thanhduy1806/EMBEDDED_LAB_TASK_1/BÀI_1/Project Outputs for BÀI_1/BOM.xlsx

Comment | Description | Designator | Footprint | LibRef | Quantity | Manufacturer | Manufacturer Part Number
4u7 |  | C200 | CAPC1005X55X30LL05T10 | CMP-0001-00074-2 | 1 | Kemet
100n |  | C201, C202, C203, C204, C205 | CAPC1005X55X30LL05T10 | CMP-0001-00074-2 | 5 | Kemet
1u |  | C206 | CAPC1005X70N | MAASL105CD7105MFCA01 | 1
100n | CAP CER 0.1UF 10V X5R 0402 | C207, C208, C209 | FP-C0402-BB-MFG | CMP-2008-02046-2 | 3 | Kemet | C0402C104K8PACTU
20pF | Dán | C210, C211 | tu 0805 | Tu 0805 20pF 50V 10% | 2
2u2 | Dán | C212, C213 | tu 0805 | Tu 0805 225 25V 10% | 2
100n | CAP CER 0.1UF 50V X7R 0402 | C300A, C300B | FP-0402B104K500CT-IPC_C | CMP-45632-000010-1 | 2
10u | Chip Multilayer Ceramic Capacitors for General Purpose, 1206, 10uF, X7R, 15%, 10%, 25V | C301A, C301B | FP-GRM31C-0_2-e0_3_0_8-MFG | CMP-06035-003589-1 | 2
1u | Chip Capacitor, 1 uF, +/- 10%, 50 V, -55 to 125 degC, 1206 (3216 Metric), RoHS, Tape and Reel | C302A, C320B | CAPC3216X110X50LL20T25 | CMP-2000-06011-1 | 2 | Kemet
10p |  | C303A, C303B | CAPC1608X90X35LL10T15 | CMP-2006-02592-1 | 2 | Murata
22u | Chip Multilayer Ceramic Capacitors for General Purpose, 0805, 22uF, X5R, 15%, 20%, 6.3V | C304A, C304B, C305A, C305B | FP-GRM21B-0_15-IPC_B | CMP-2007-03385-2 | 4
1u |  | C306A, C306B | CAPC2013X140X50NL20T25 | CMP-2007-03234-1 | 2 | Kemet
100n | Automotive Ceramic Capacitor, 0603, 100nF, 10%, X7R, 15%, 50V | C400A, C400B | FP-0603-L_1_6_0_15-W_0_81-IPC_A | CMP-2006-04386-2 | 2
22u | Tantalum Capacitor, 22 uF, +/- 10%, 10 V, -55 to 125 degC, 2-Pin SMD, RoHS, Tape and Reel | C401A, C401B | KEMT-T491-B_L | CMP-2000-07193-1 | 2 | Kemet
10u | Chip Capacitor, 10 uF, +/- 10%, 10 V, -55 to 125 degC, 1206 (3216 Metric), RoHS, Tape and Reel | C500A, C500B, C501A, C501B | CAPC3216X180X50LL20T25 | CMP-2000-06013-1 | 4 | Kemet
22u | CAP 22uF 6.3V ±20% 1206 (3216 Metric) Thickness 1.9mm SMD | C502A, C502B, C503A, C503B, C504A, C504B | CAPC1206(3216)190_L | CMP-1037-04986-1 | 6
100n | Cap Ceramic 100nF 50V X7R 10% Pad SMD 0603 +125°C Automotive T/R | C505A, C? | FP-CGA3E-0_3-0_1-IPC_A | CMP-2000-07546-2 | 2
LED | LED GREEN DIFFUSED 1206 SMD | D700, D701, D702 | FP-HSMG-C150-MFG | CMP-2000-05061-2 | 3 | Broadcom | HSMG-C150
XT30PW-M | Socket; DC supply; XT30; male; PIN: 2; on PCBs; THT; Colour: yellow | J300A, J300B, J301A, J301B | AMASS_XT30PW-M | XT30PW-M | 4
RPI GPIO Cconnector + 4 Cubesat pins |  | J600 |  | Connector GPIO | 1
S6B-XH-A (LF)(SN) | CONN HEADER R/A 6POS 2.5MM | J700 | FP-S6B-XH-A_LF_SN-MFG | CMP-17439-000165-2 | 1
4u7 | Surface Mount High Frequency Inductor, MLP Series, 4.7 H, 20%, 0805 [2012 Metric], 0.26 ohm | L200 | INDC2012X100N | MLP2012S4R7MT0S1 | 1
10u | 74477710, CUỘN CẢM LÕI FERALIT | L300A, L300B | WE-PD_7345 | CMP-0227-00113-2 | 2
1u5 | Shielded Wirewound Inductor 1.5uH 2500mA 0.072Ω 1008 (2520) | L500A, L500B | FP-DFE252010C-IPC_A | CMP-06042-006286-1 | 2
NT |  | N3A, NT1A, NT1B, NT2A, NT2B, NT3B | NET TIE | NET_TIRE | 6
61201021721 |  | P? | 61201021721 | CMP-1502-00021-2 | 1
TPCA8120 | MOSFET P-CH 20V 2A SSOT3 | Q400A, Q400B | FP-527AG-MFG | CMP-2100-03638-2 | 2
AO3400A | Trans MOSFET N-CH 30V 5.7A 3-Pin SOT-23 | Q700, Q701 | SOT95P280X125-3N | AO3400A | 2
10k | Chip Resistor, 10 KOhm, +/- 1%, 100 mW, -55 to 155 degC, 0603 (1608 Metric), RoHS, Tape and Reel | R200, R201, R204, R205, R206, R210, R301A, R301B, R302A, R302B, R304A, R304B | RESC1609X50X30NL8T20 | CMP-1666-00005-4 | 12 | Vishay Semiconductor
33k |  | R202, R203 | RESC1005X40X25ML05T10 | CMP-2002-07617-1 | 2 | Yageo / Phycomp
100R |  | R207, R208, R209, R700, R702 | RESC1005X40X25ML05T10 | CMP-2002-07344-1 | 5 | Yageo / Phycomp
0.025R | RES 0.025 OHM 1% 1W 2512 | R300A, R300B | FP-WSL2512-0_762-MFG | CMP-02407-013157-1 | 2
1M 1% |  | R303a, R303B | RESC1005X40X25NL05T10 | CMP-2002-07490-1 | 2 | Yageo / Phycomp
60k4 |  | R305A, R305B | RESC2013X50X30NL20T20 | CMP-2001-04043-1 | 2 | Vishay Dale
309k | ERJ-8ENF3093V | R306A, R306B | RESC3216X70X50LL05T20 | CMP-2003-00293-1 | 2 | Panasonic
10k | Chip Resistor, 10 KOhm, +/- 1%, 0.125 W, -55 to 155 degC, 0805 (2012 Metric), RoHS, Tape and Reel | R500A, R500B, R502A, R502B | RESC2013X60X35NL10T20 | CMP-1659-00013-4 | 4 | Yageo
1M 1% | Chip Resistor, 1 MOhm, +/- 1%, 100 mW, -55 to 155 degC, 0603 (1608 Metric), RoHS, Tape and Reel | R501A, R501B | RESC1608X55X25LL10T15 | CMP-1659-00056-1 | 2
180K | Chip Resistor, 180 KOhm, +/- 1%, 62.5 mW, -55 to 155 degC, 0402 (1005 Metric), RoHS, Tape and Reel | R503A, R503B | RESC1005X40X25NL05T10 | CMP-1011-00763-4 | 2 | Basic Passives
100R | Chip Resistor, 10 KOhm, +/- 1%, 100 mW, -55 to 155 degC, 0603 (1608 Metric), RoHS, Tape and Reel | R701, R703 | RESC1609X50X30NL8T20 | CMP-1666-00005-4 | 2 | Vishay Semiconductor
1k | Chip Resistor, 1 KOhm, +/- 1%, 0.125 W, -55 to 155 degC, 0805 (2012 Metric), RoHS, Tape and Reel | R704, R705 | RESC2013X70X40LL20T20 | CMP-2001-04375-5 | 2 | Panasonic
2k2 |  | R706 | RESC1609X50X30NL10T20 | CMP-2000-03167-1 | 1 | Vishay Dale
B3F-3152 | SWITCH TACTILE SPST-NO 0.05A 24V | SW200, SW201, SW202 | FP-B3F-3152-MFG | CMP-08834-000033-1 | 3
TestPoint |  | TP300A, TP300B, TP700, TP701 | PCBComponent_1 | TestPoint | 4
LT8611EUDD | IC REG BUCK ADJ 2.5A 24QFN | U300A, U300B | FP-UDD-24-05-08-1833-IPC_B | CMP-0491-02169-2 | 2
LTC4412ES6 | IC OR CTRLR SRC SELECT TSOT23-6 | U400A, U400B | FP-S6-6-05-08-1636-IPC_C | CMP-0479-00425-2 | 2
TPS63020DSJT | IC REG BCK BST ADJ 3.5A 14VSON | U500A, U500B | FP-DSJ0014A-MFG | CMP-2000-07282-2 | 2 | Texas Instruments | TPS63020DSJT
STM32F405RGT6 | ARM Cortex-M4 32-bit MCU+FPU, 210 DMIPS, 1024 kB Flash, 192 kB Internal RAM, 51 I/Os, 64-pin LQFP, -40 to 85 degC, Tray | U? | STM-LQFP64_N | CMP-0243-00019-3 | 2 | STMicroelectronics
8MHz | Low Profile Crystal, 8.0 MHz, +/- 30 ppm, -20 to 70 degC, 2-Pin SMD, RoHS, Tape and Reel | X? | ABRA-ABLS-14.7456MHZ-B2-T_V | CMP-2000-05726-1 | 1 | ABRACON
