thanhduy1806/EMBEDDED_LAB_TASK_1/ĐỀ/EPS_board.pdf

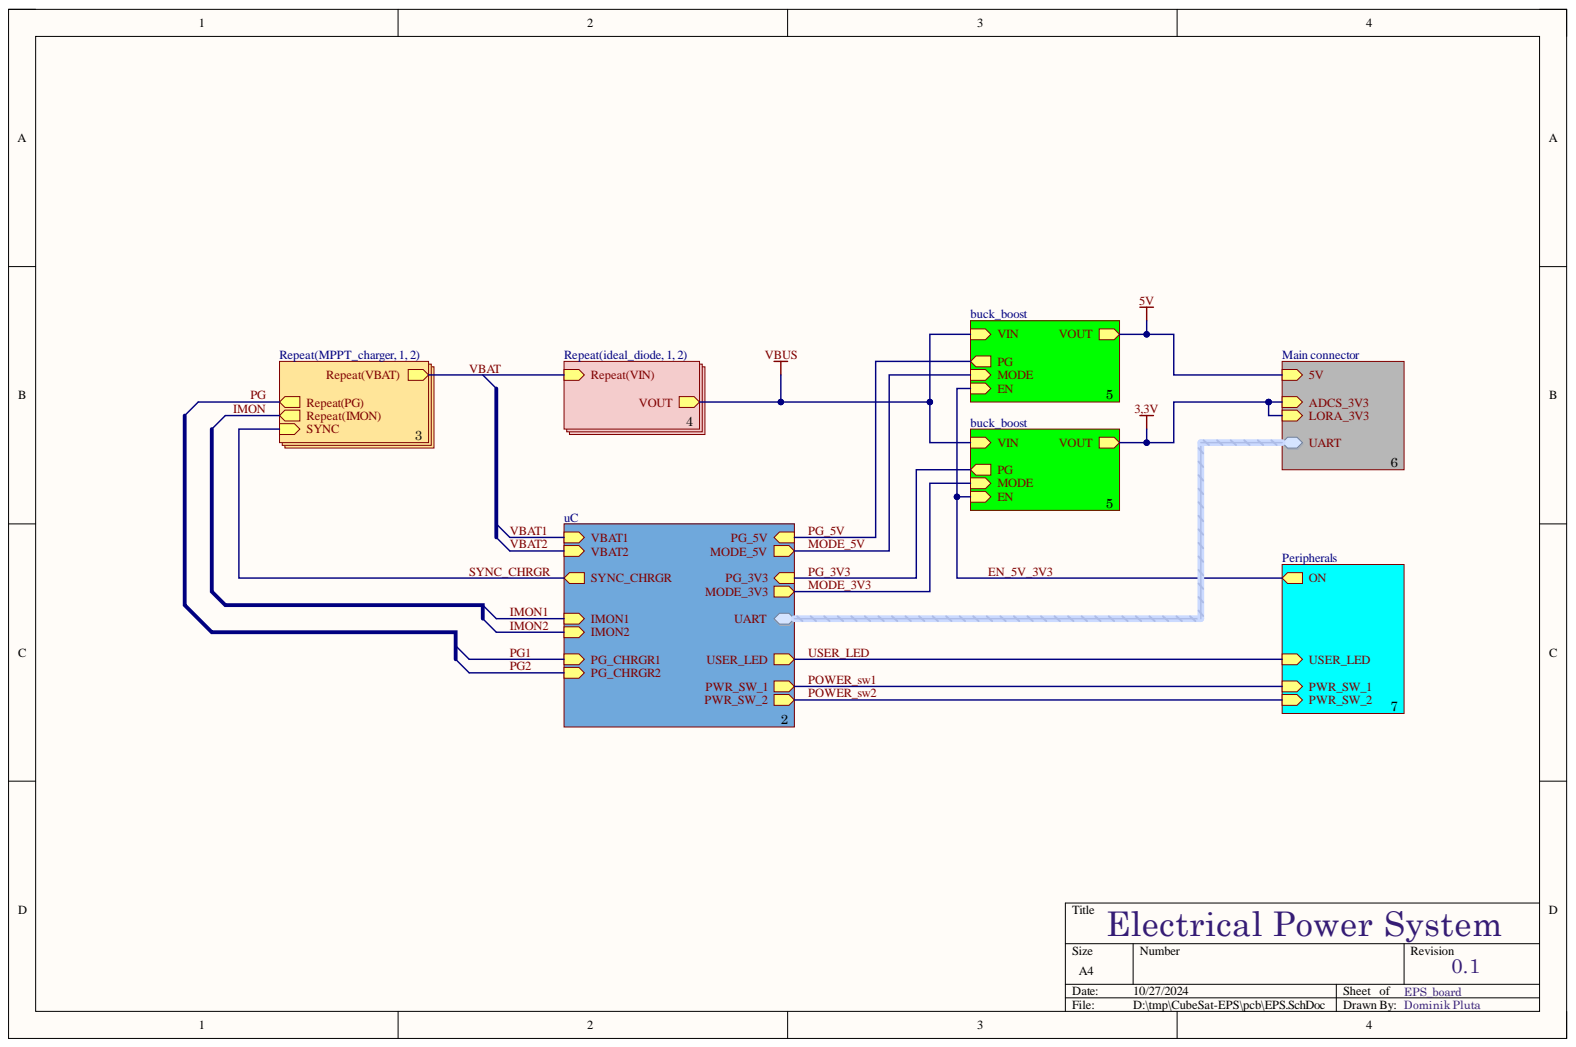
[picture p1: page 1]

PG_ 5 V
MODE _5 V

Siz e A4 | Numb e r | R evisio n 0 . 1

Da te : 10/27/20 24 | She et of EPS_boa r d
File : D:\tmp\Cube S at-EP S\pcb\EP S . S c hD o c | Dr awn B y : Dom i n ik Pl u t a

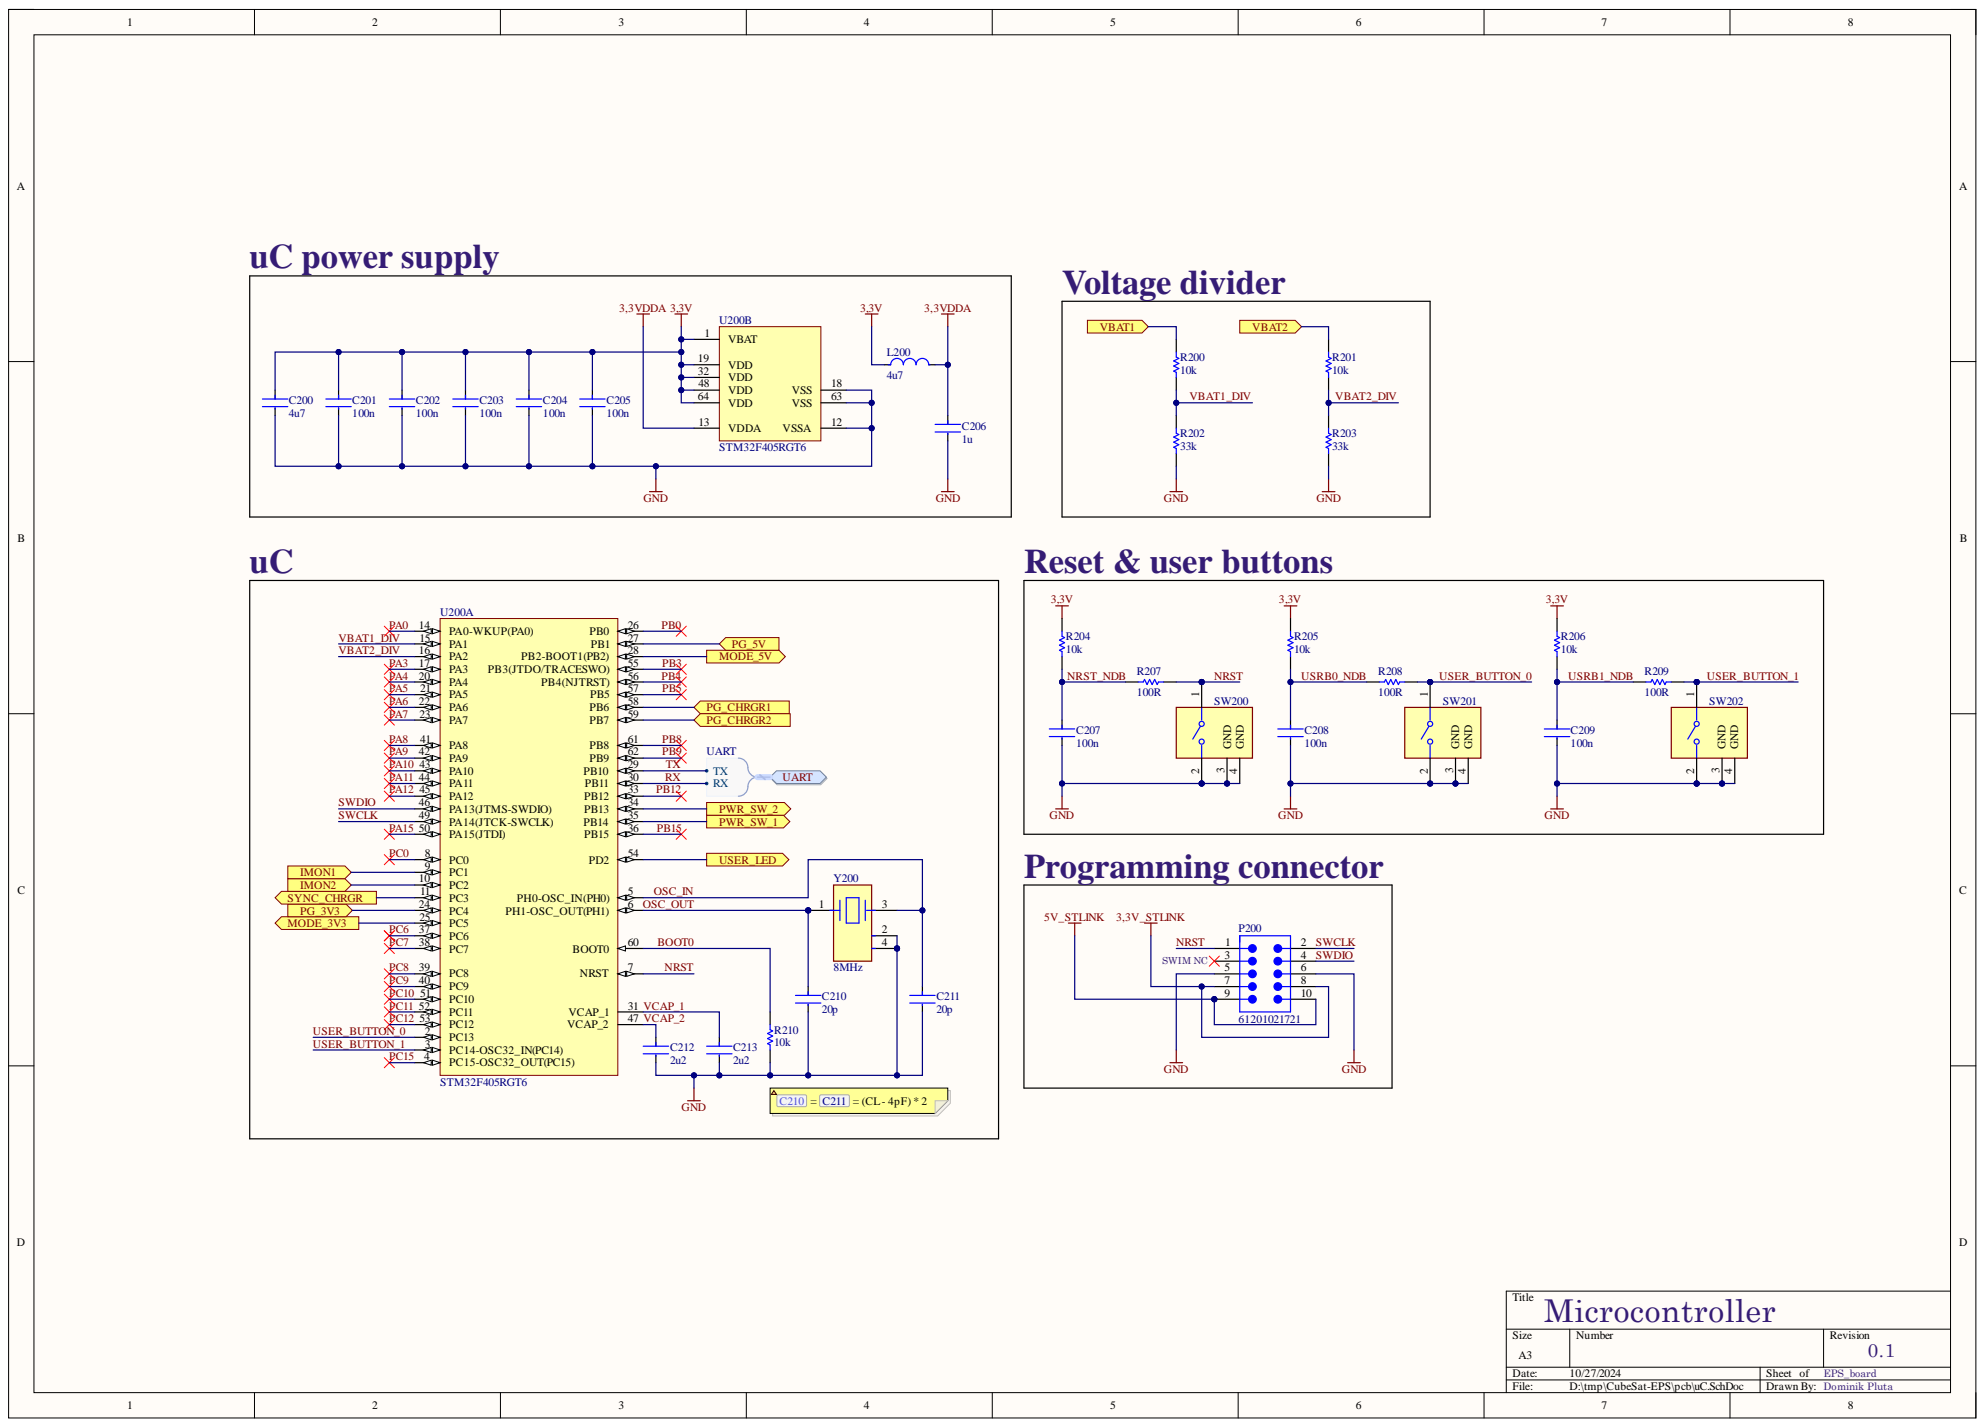
[picture p2: page 2]

VDD 19
VDD 32
VDD 48

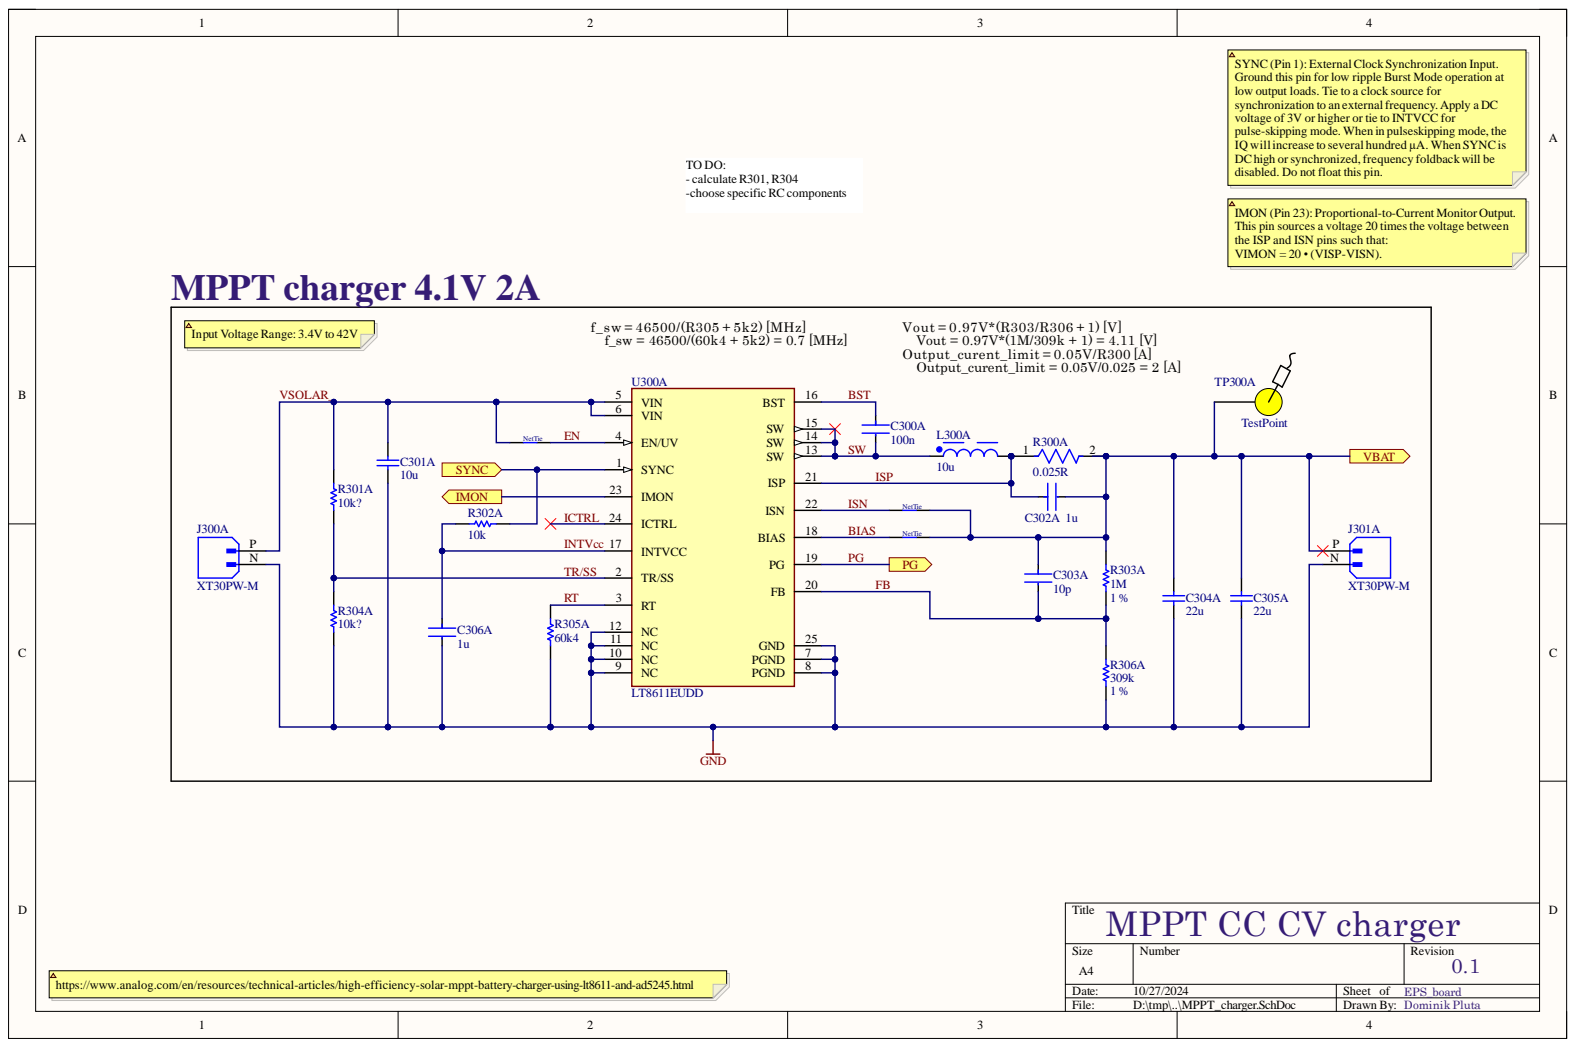
[picture p3: page 3]

SYNC(Pin 1): External Clock Synchronization Input.
Ground this pin for low ripple Burst Mode operation at
low output loads. Tie to a clock source for
synchronization to an external frequency. Apply a DC
voltage of 3V or higher or tie to INTVCC for
pulse-skipping mode. When in pulseskipping mode, the
IQ will increase to several hundred µA. When SYNCis
DChigh orsynchronized,frequency foldback will be
disabled. Do not float this pin.

IMON (Pin 23): Proportional-to-Current Monitor Output.
This pin sources a voltage 20 times the voltage between
the ISP and ISN pins such that:
VIMON = 20 • (VISP-VISN).

f_sw = 46500/(60k4 + 5k2) = 0.7 [MHz] Input VoltageRange: 3.4V to 42V

EN NetTie | VIN 6

SYNC 1

ICTRL | ICTRL 24 | ISN NetTie

BIAS NetTie

Title
MPPT CC CV charger

Size A4 | Number | Revision 0.1

https://www.analog.com/en/resources/technical-articles/high-efficiency-solar-mppt-battery-charger-using-lt8611-and-ad5245.html

Date: 10/27/2024 | Sheet of EPS_board
File: D:\tmp\..\MPPT_charger.SchDoc | Drawn By: Dominik Pluta

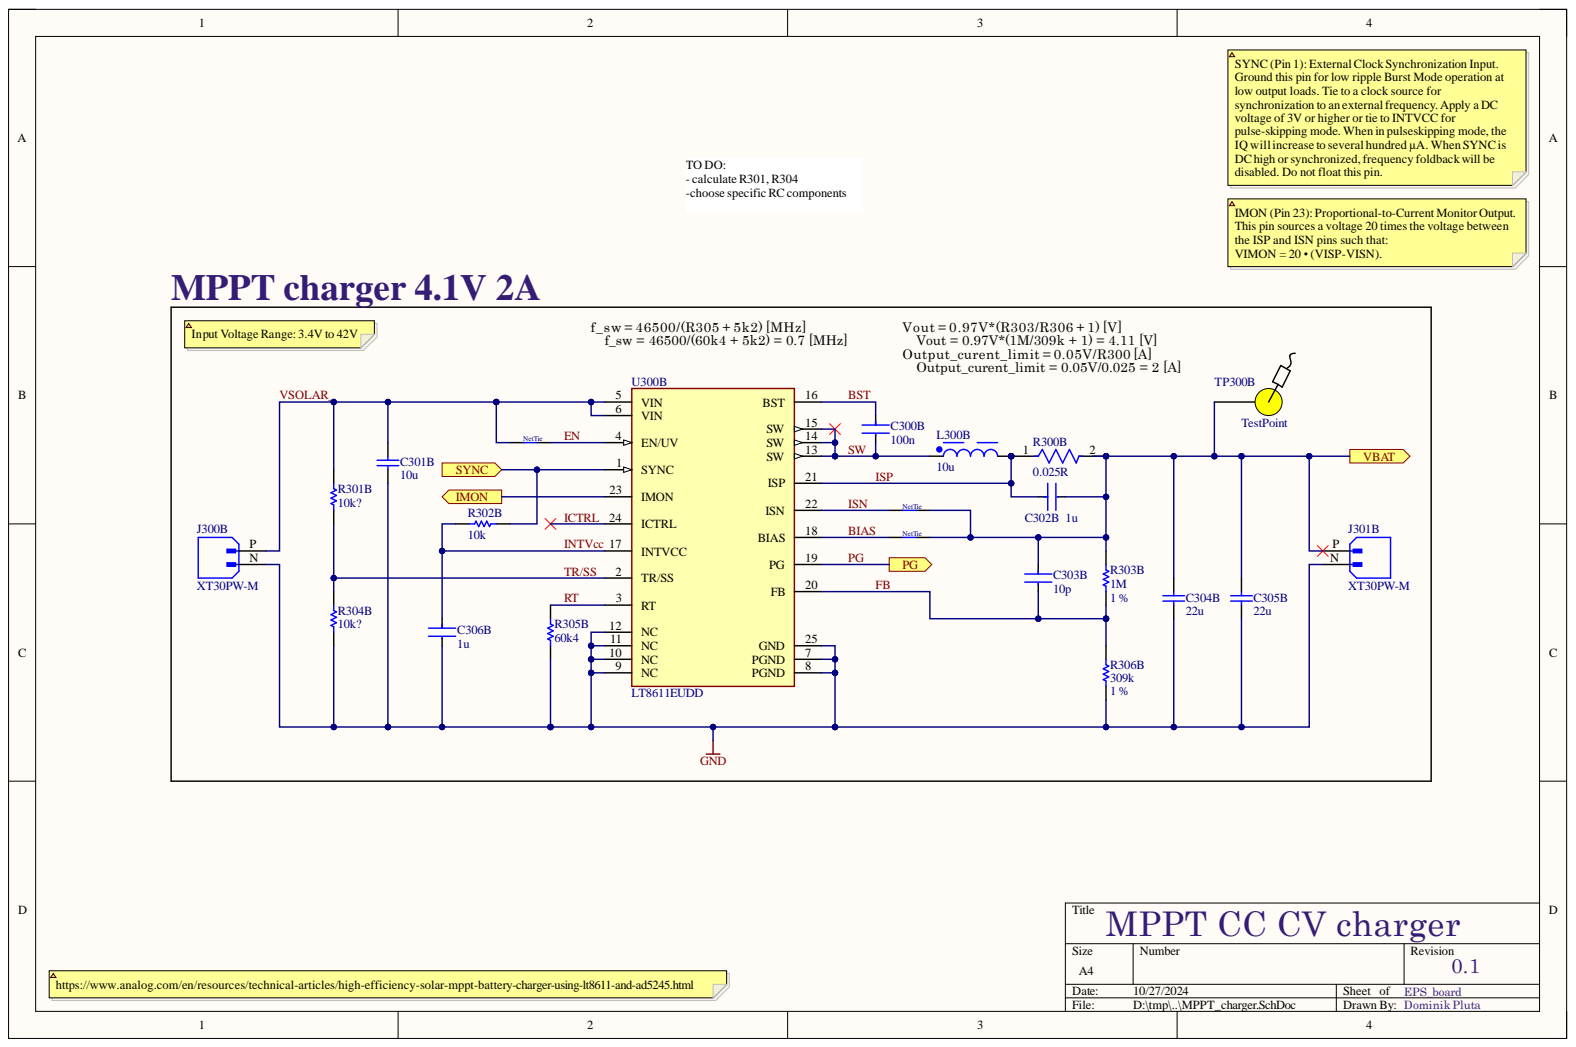
[picture p4: page 4]

SYNC
Ground this pin
low output loads.
synchroniz
voltage of 3V or highe
pulse
DChigh orsynchroniz

When in pulseskipping mode
al hundr

a voltage 20 times the voltage betwe
SN pins such that:

B IAS N e t Ti e

Siz e A4 | Numb e r | R evisio n . 1

Da te : 10/27/20 24 | She et of EPS_boa r d
File : D:\tmp\. .\MP PT_c h ar g e r . S c hD o c | Dr awn B y : Dom i n ik Pl u t a

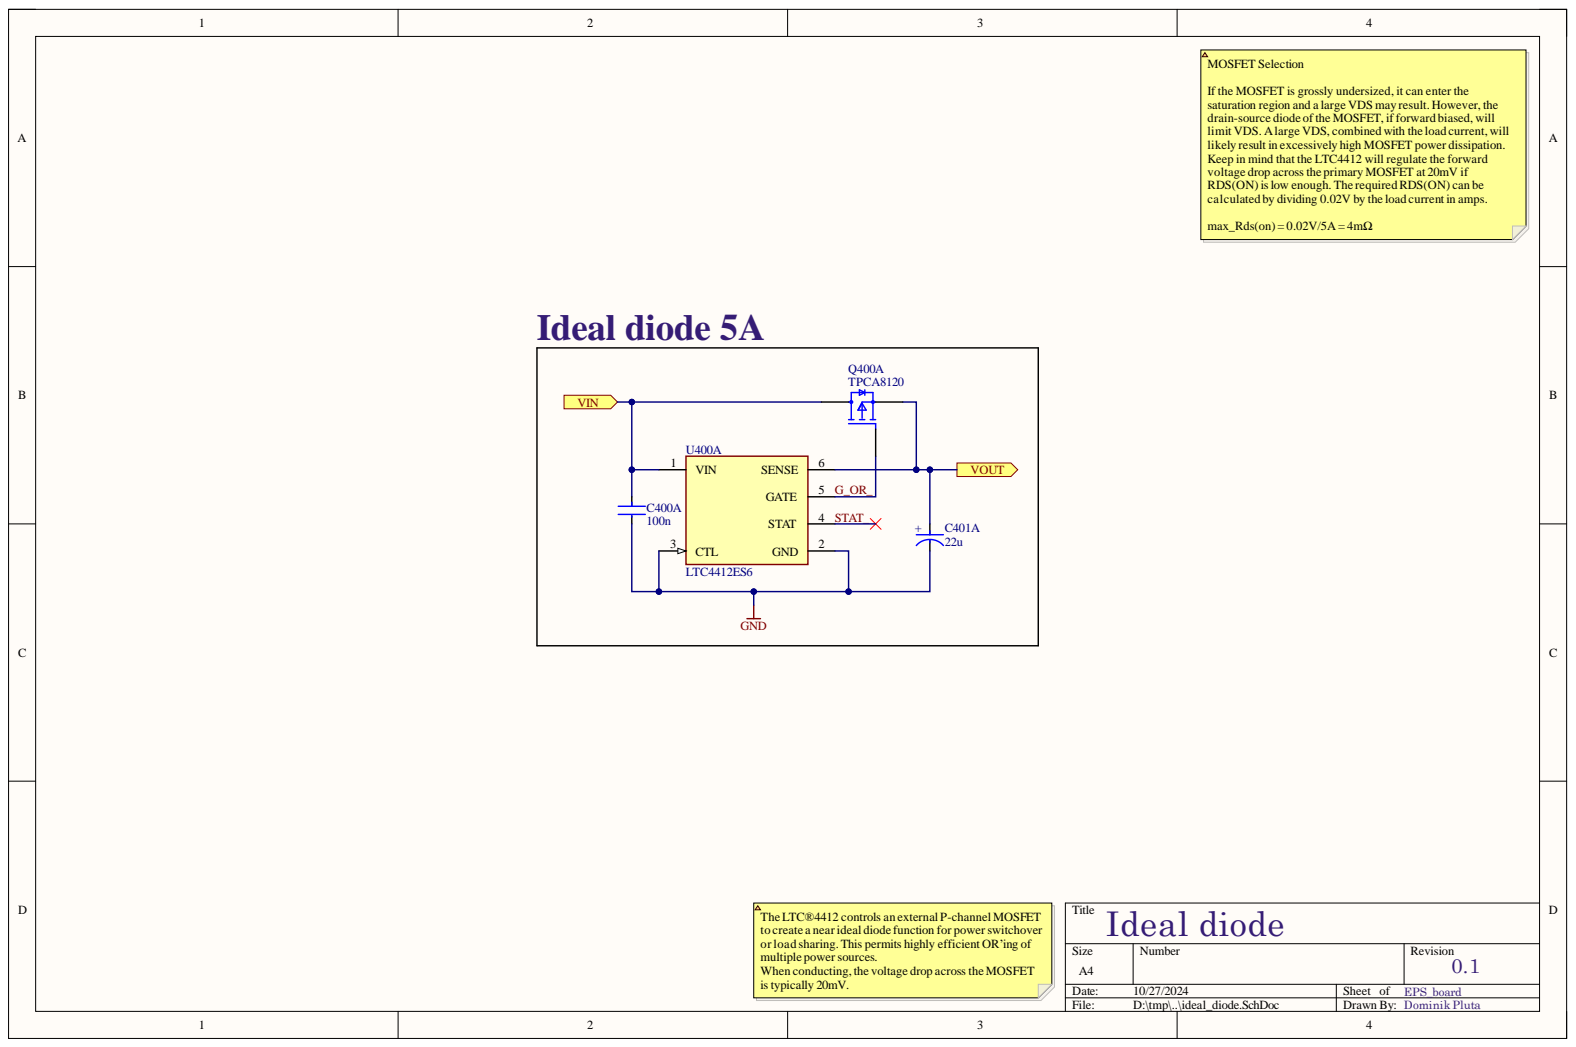
[picture p5: page 5]

If the MOSFET is grossly undersized, it can enter the
saturation region and a large VDSmay result. However, the
drain-source diode ofthe MOSFET, ifforward biased, will
limit VDS. Alarge VDS, combined with the load current, will
likely result in excessively high MOSFET power dissipation.
Keep in mind that the LTC4412 will regulate the forward
voltage drop across the primary MOSFET at 20mV if
RDS(ON)is low enough. The required RDS(ON) can be
calculated by dividing 0.02V by the load current in amps.

The LTC®4412 controls an external P-channel MOSFET
to create a near ideal diode function for powerswitchover
or load sharing. This permits highly efficient OR’ing of
multiple powersources.
When conducting, the voltage drop across the MOSFET
is typically 20mV.

Size A4 | Number | Revision 0.1

Date: 10/27/2024 | Sheet of EPS_board
File: D:\tmp\..\ideal_diode.SchDoc | Drawn By: Dominik Pluta

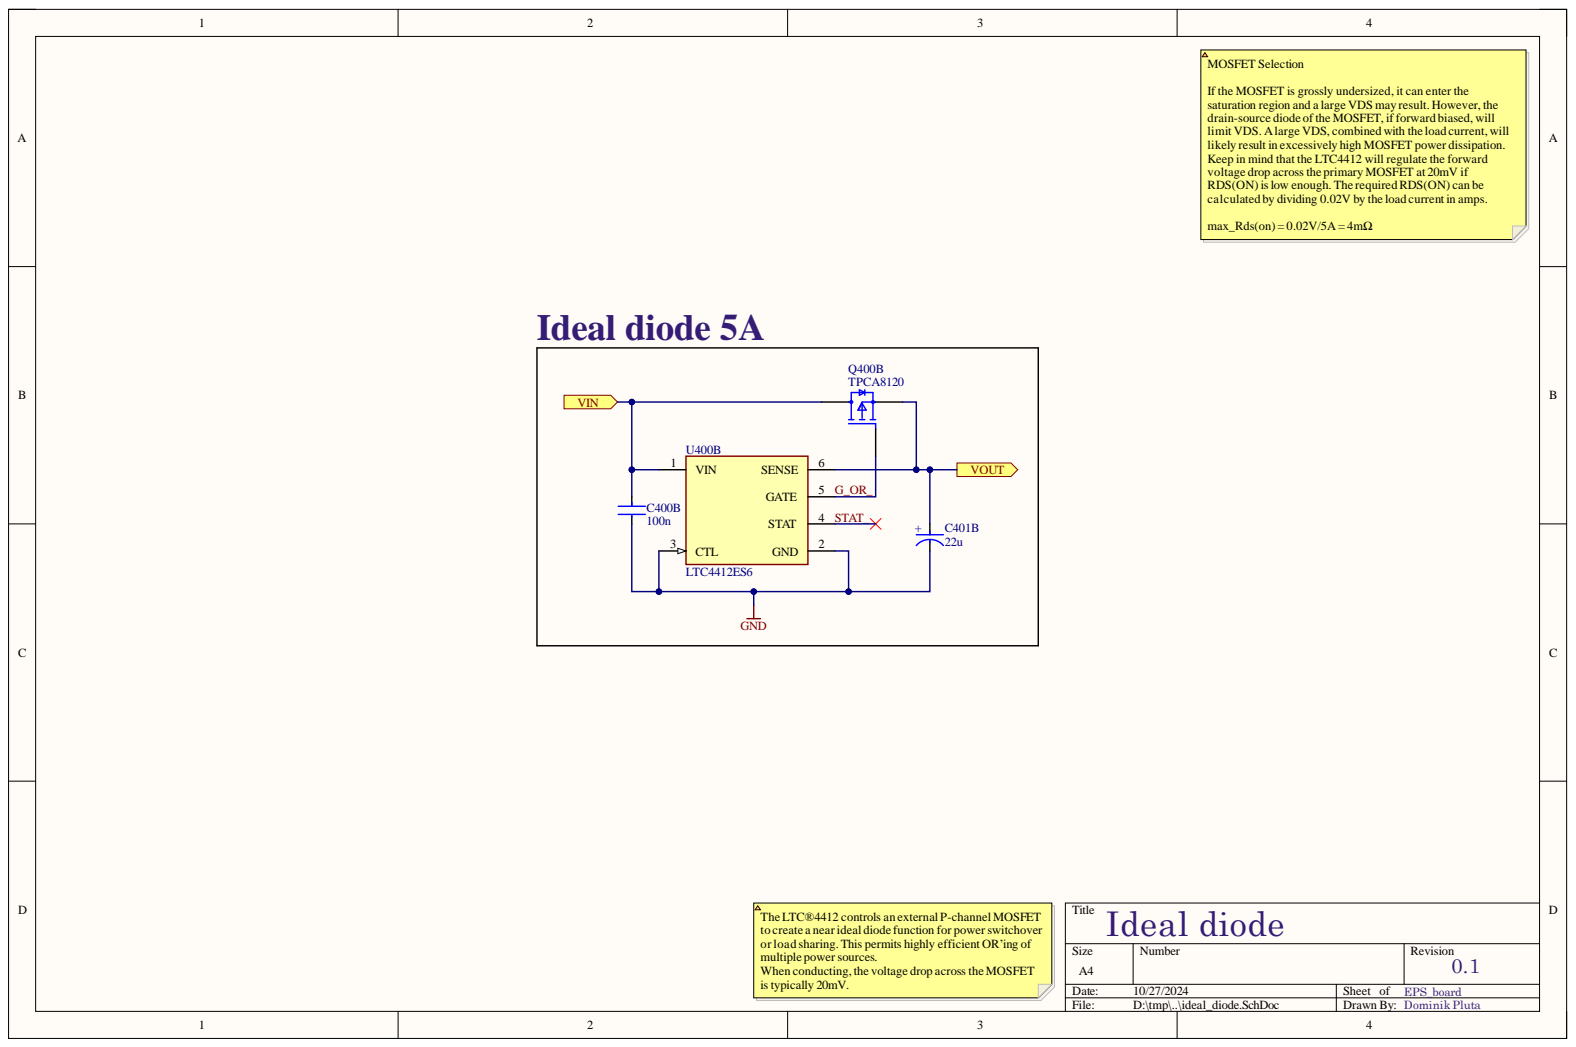
[picture p6: page 6]
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

Size A4 | Number | Revision 0.1

Date: 10/27/2024 | Sheet of EPS_board
File: D:\tmp\..\ideal_diode.SchDoc | Drawn By: Dominik Pluta

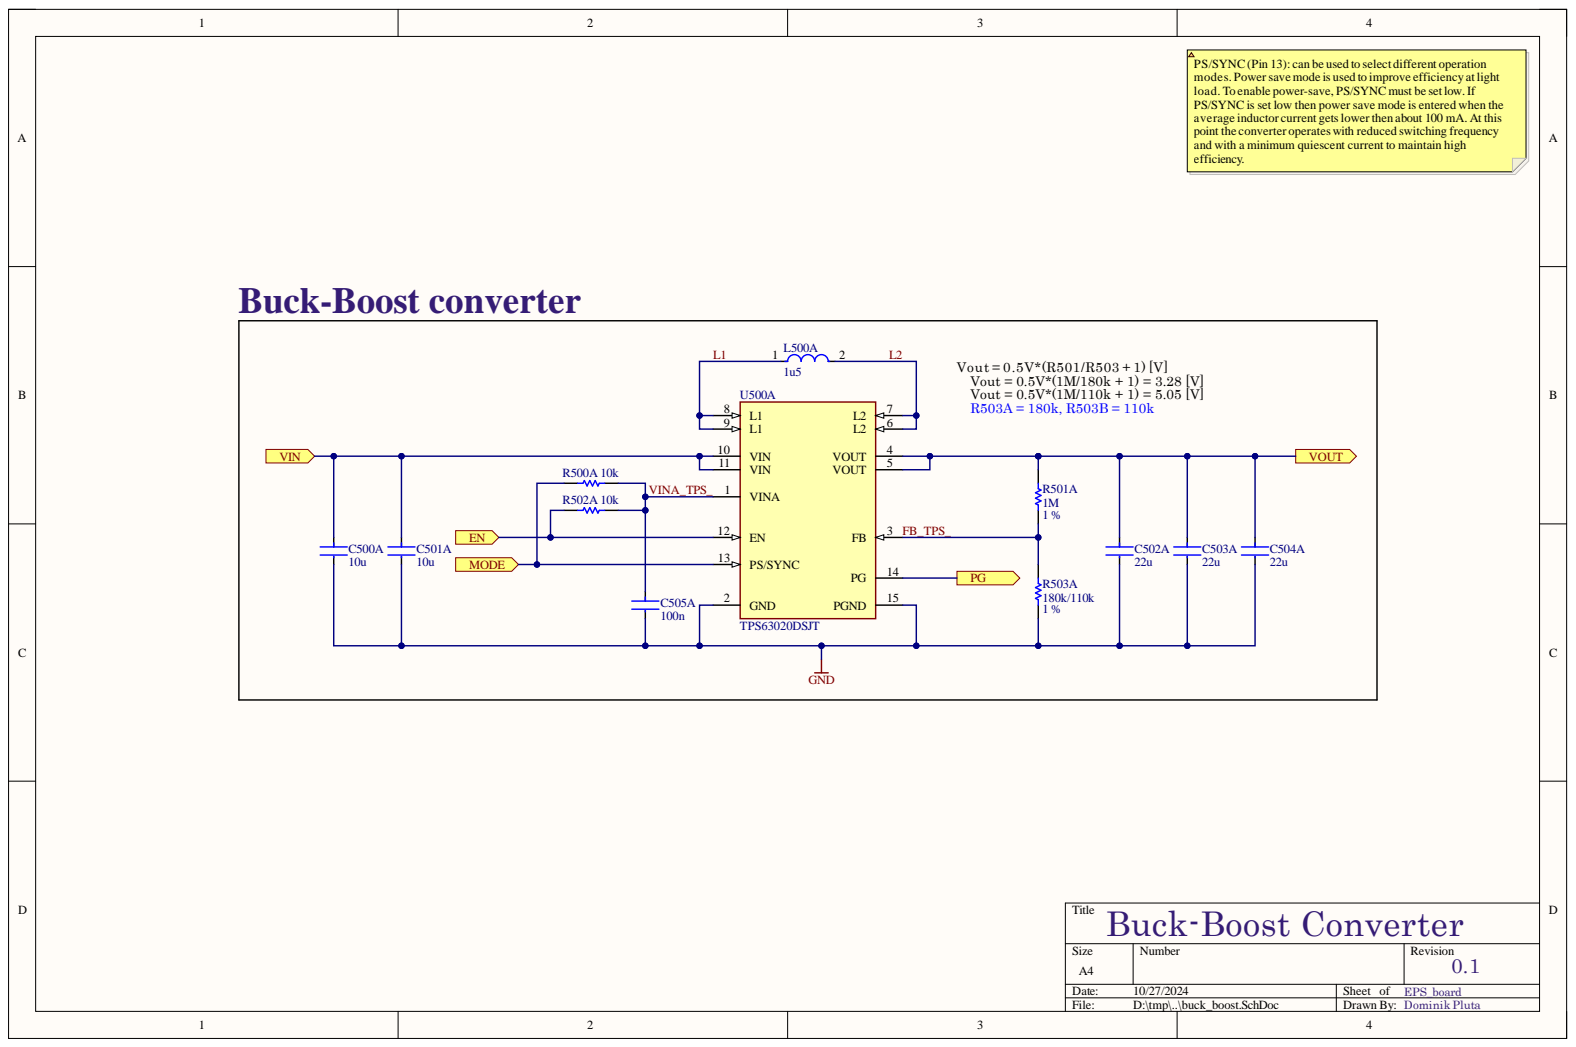
[picture p7: page 7]

rsave mode is used to improve
enable powe

an be used to sele

S/SYNCmust be set low

ent to maintain high

Siz e A4 | Numb e r | R evisio n . 1

Da te : 10/27/20 24 | She et of EPS_boa r d
File : D:\tmp\. .\buck_boost . S c hD o c | Dr awn B y : Dom i n ik Pl u t a

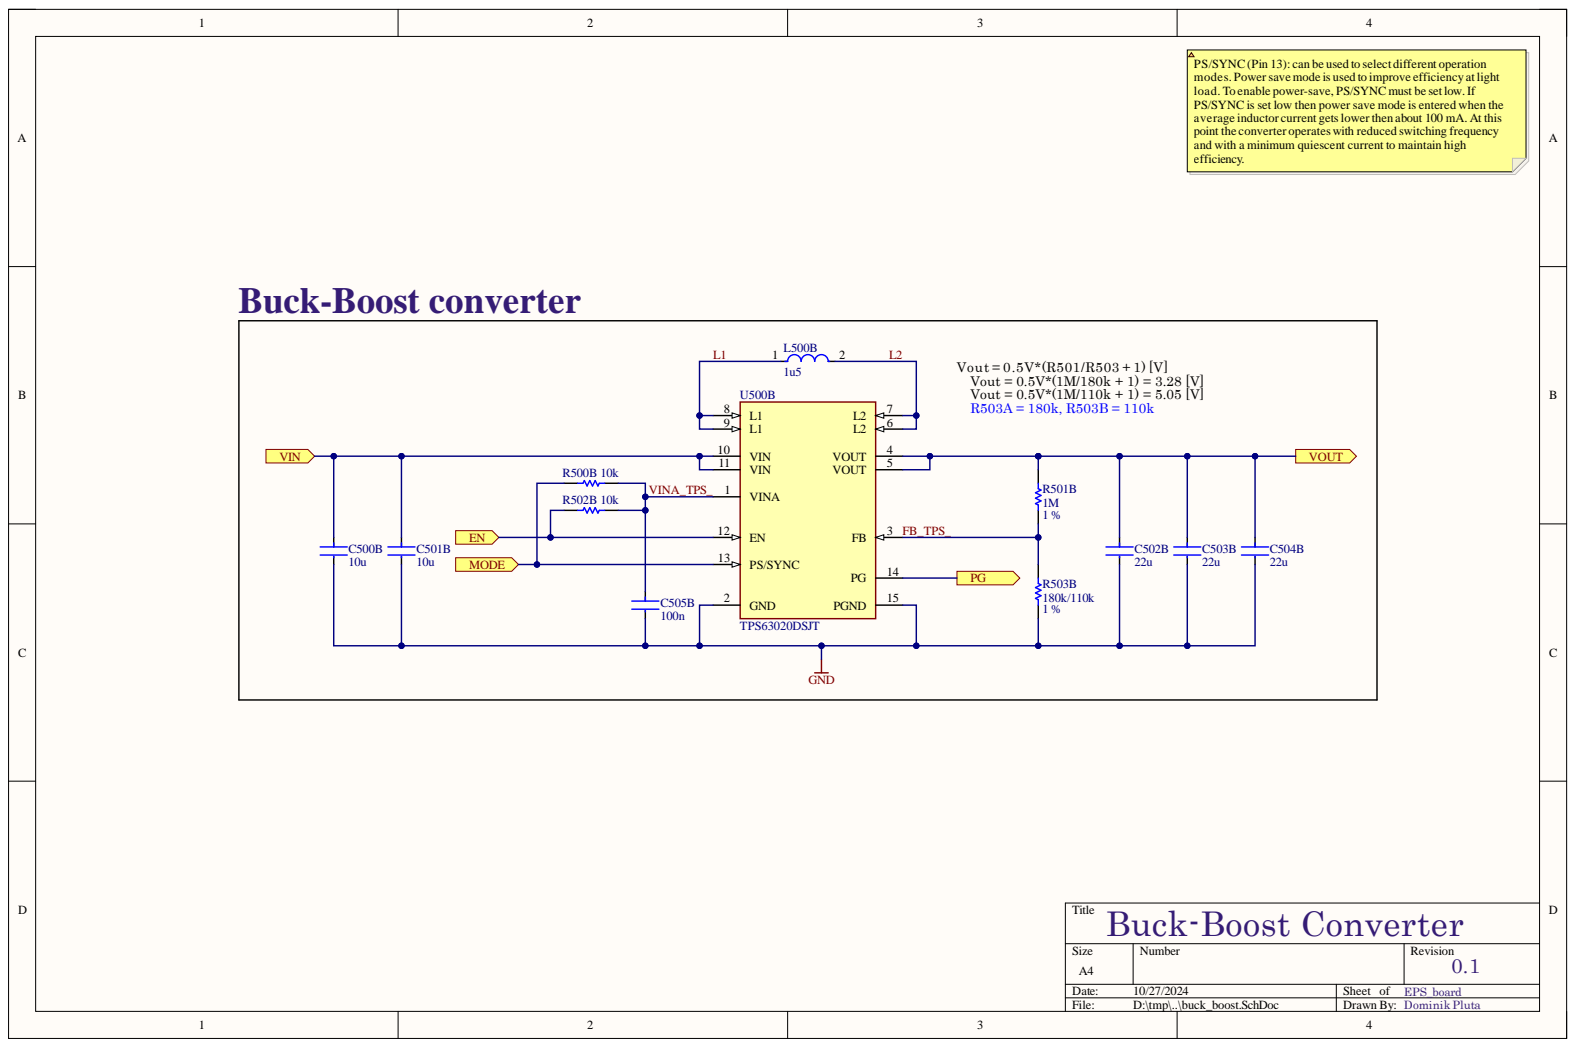
[picture p8: page 8]

PS/SYNC(Pin 13): can be used to select different operation
modes. Powersave mode is used to improve efficiency at light
load. To enable power-save, PS/SYNCmust be set low. If
PS/SYNC is set low then power save mode is entered when the
average inductor current gets lower then about 100 mA. At this
point the converter operates with reduced switching frequency
and with a minimum quiescent current to maintain high
efficiency.

Size A4 | Number | Revision 0.1

Date: 10/27/2024 | Sheet of EPS_board
File: D:\tmp\..\buck_boost.SchDoc | Drawn By: Dominik Pluta

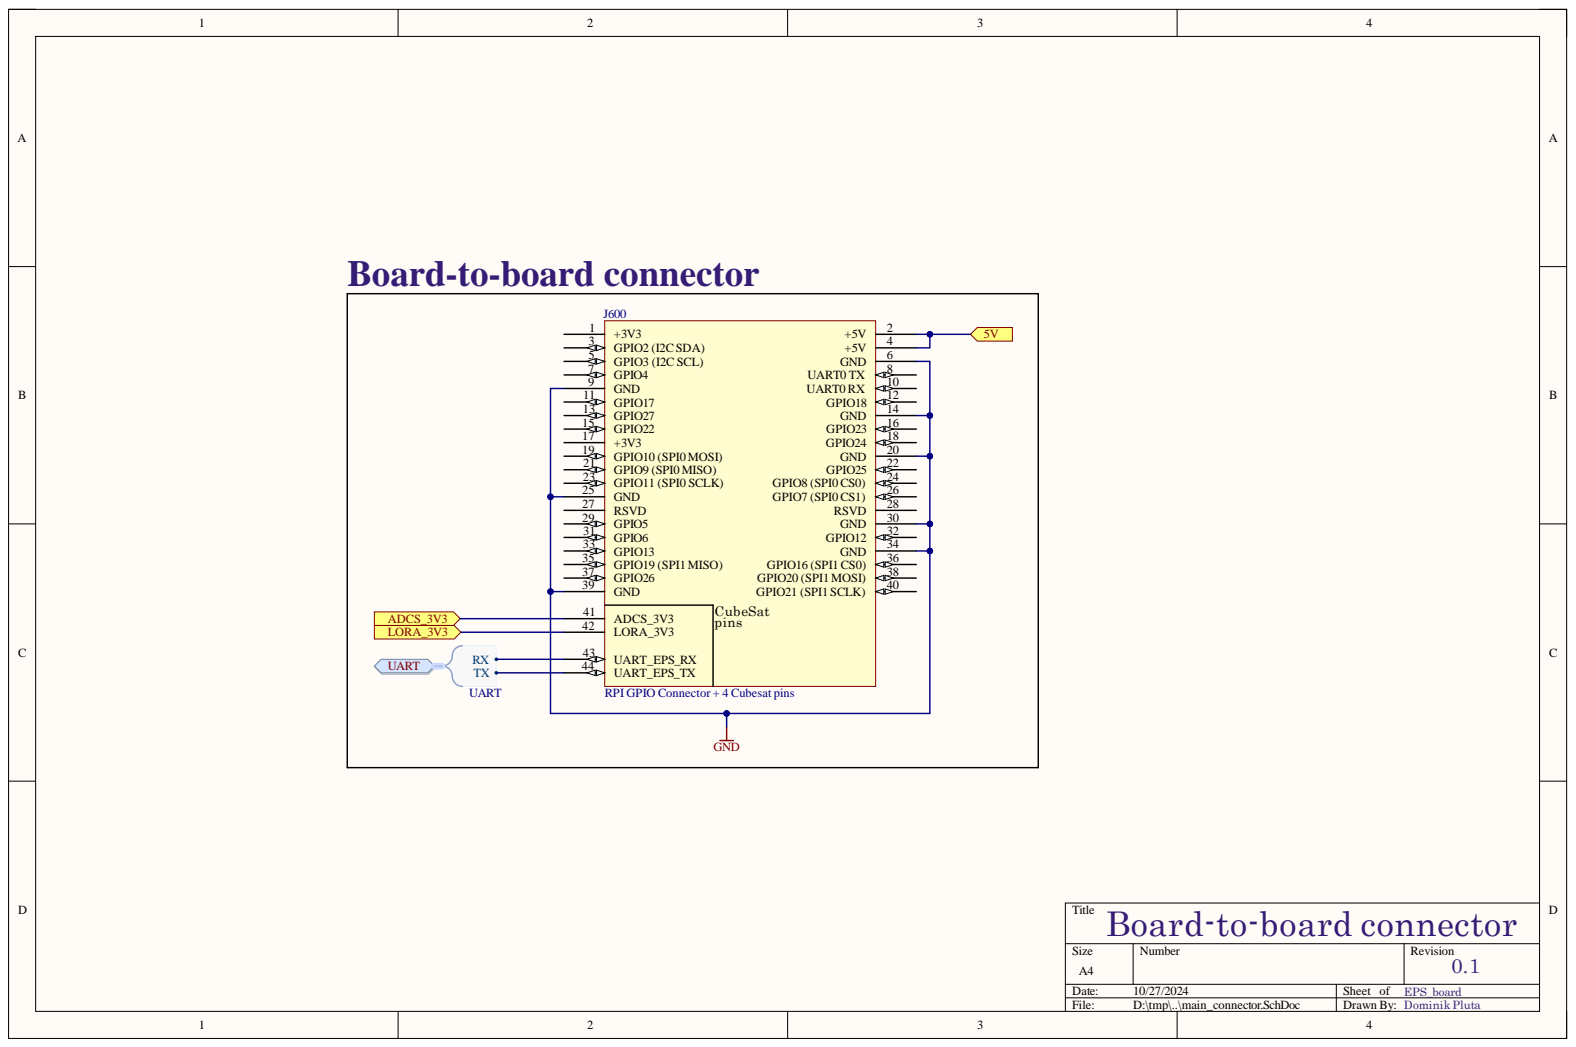
[picture p9: page 9]

Board-to-board connector

RPI GPIO Connector + 4 Cubesat pins

Title

Size A4 | Number | Revision 0.1

Date: 10/27/2024 | Sheet of EPS_board
File: D:\tmp\..\main_connector.SchDoc | Drawn By: Dominik Pluta

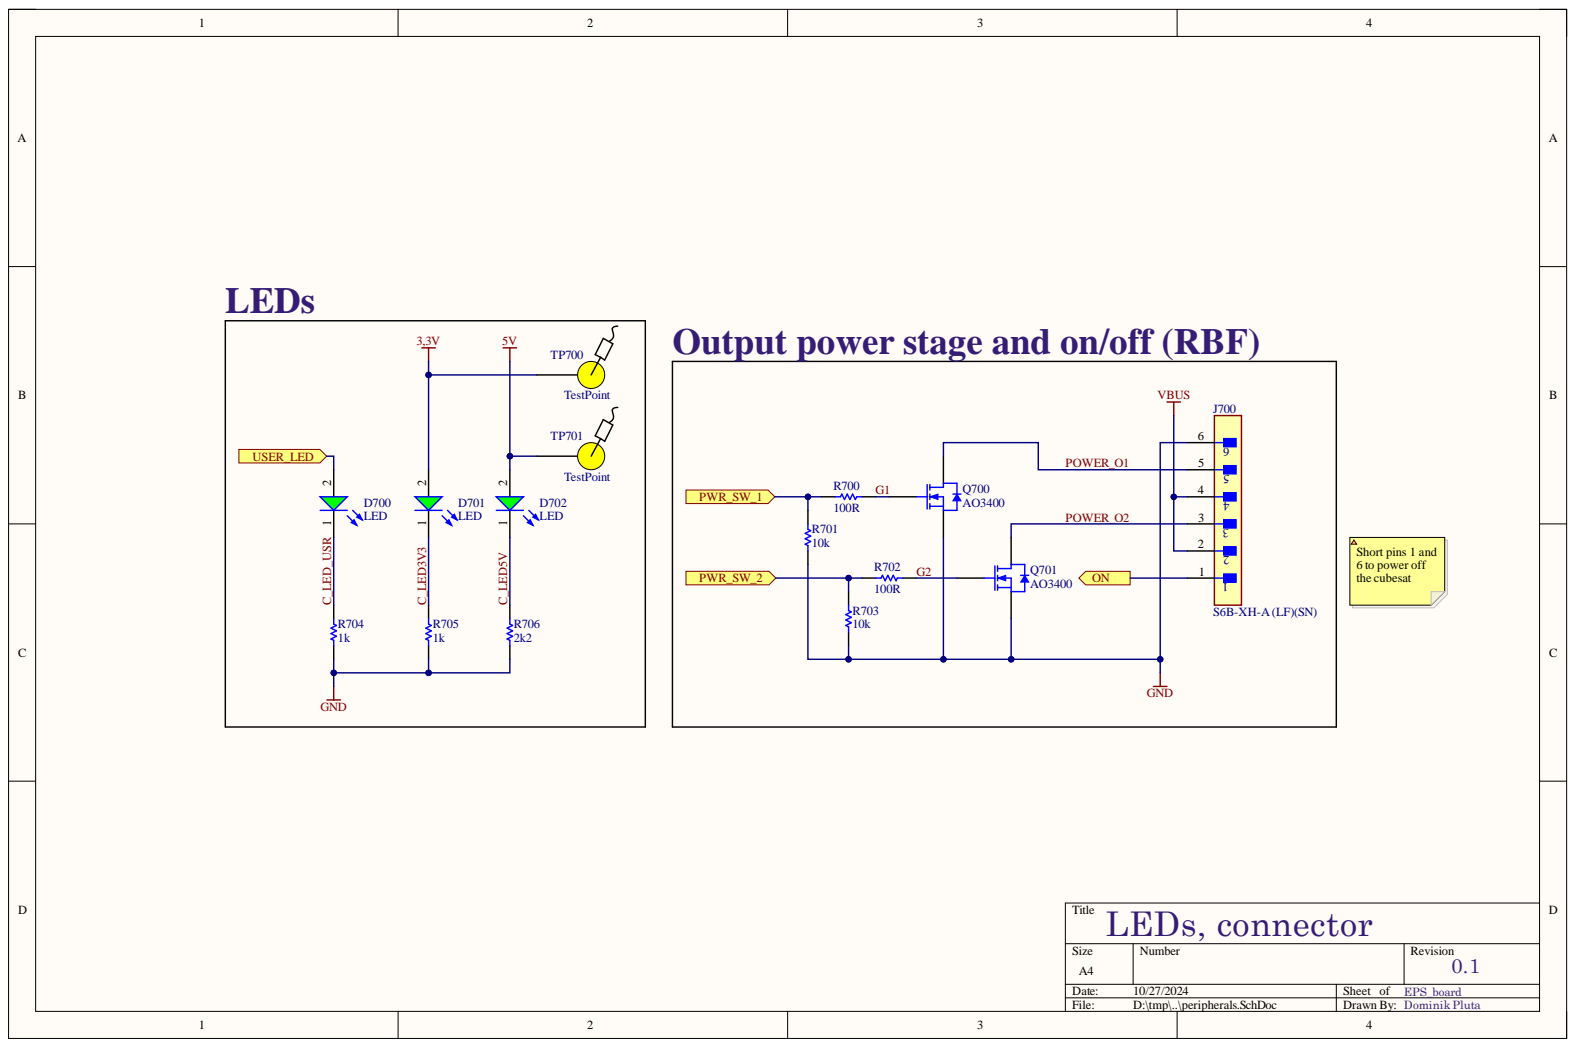
[picture p10: page 10]

POW ER_O 1

Siz e A4 | Numb e r | R evisio n 0 . 1

Da te : 10/27/20 24 | She et of EPS_boa r d
File : D:\tmp\. .\pe riphe r a l s . S c hD o c | Dr awn B y : Dom i n ik Pl u t a

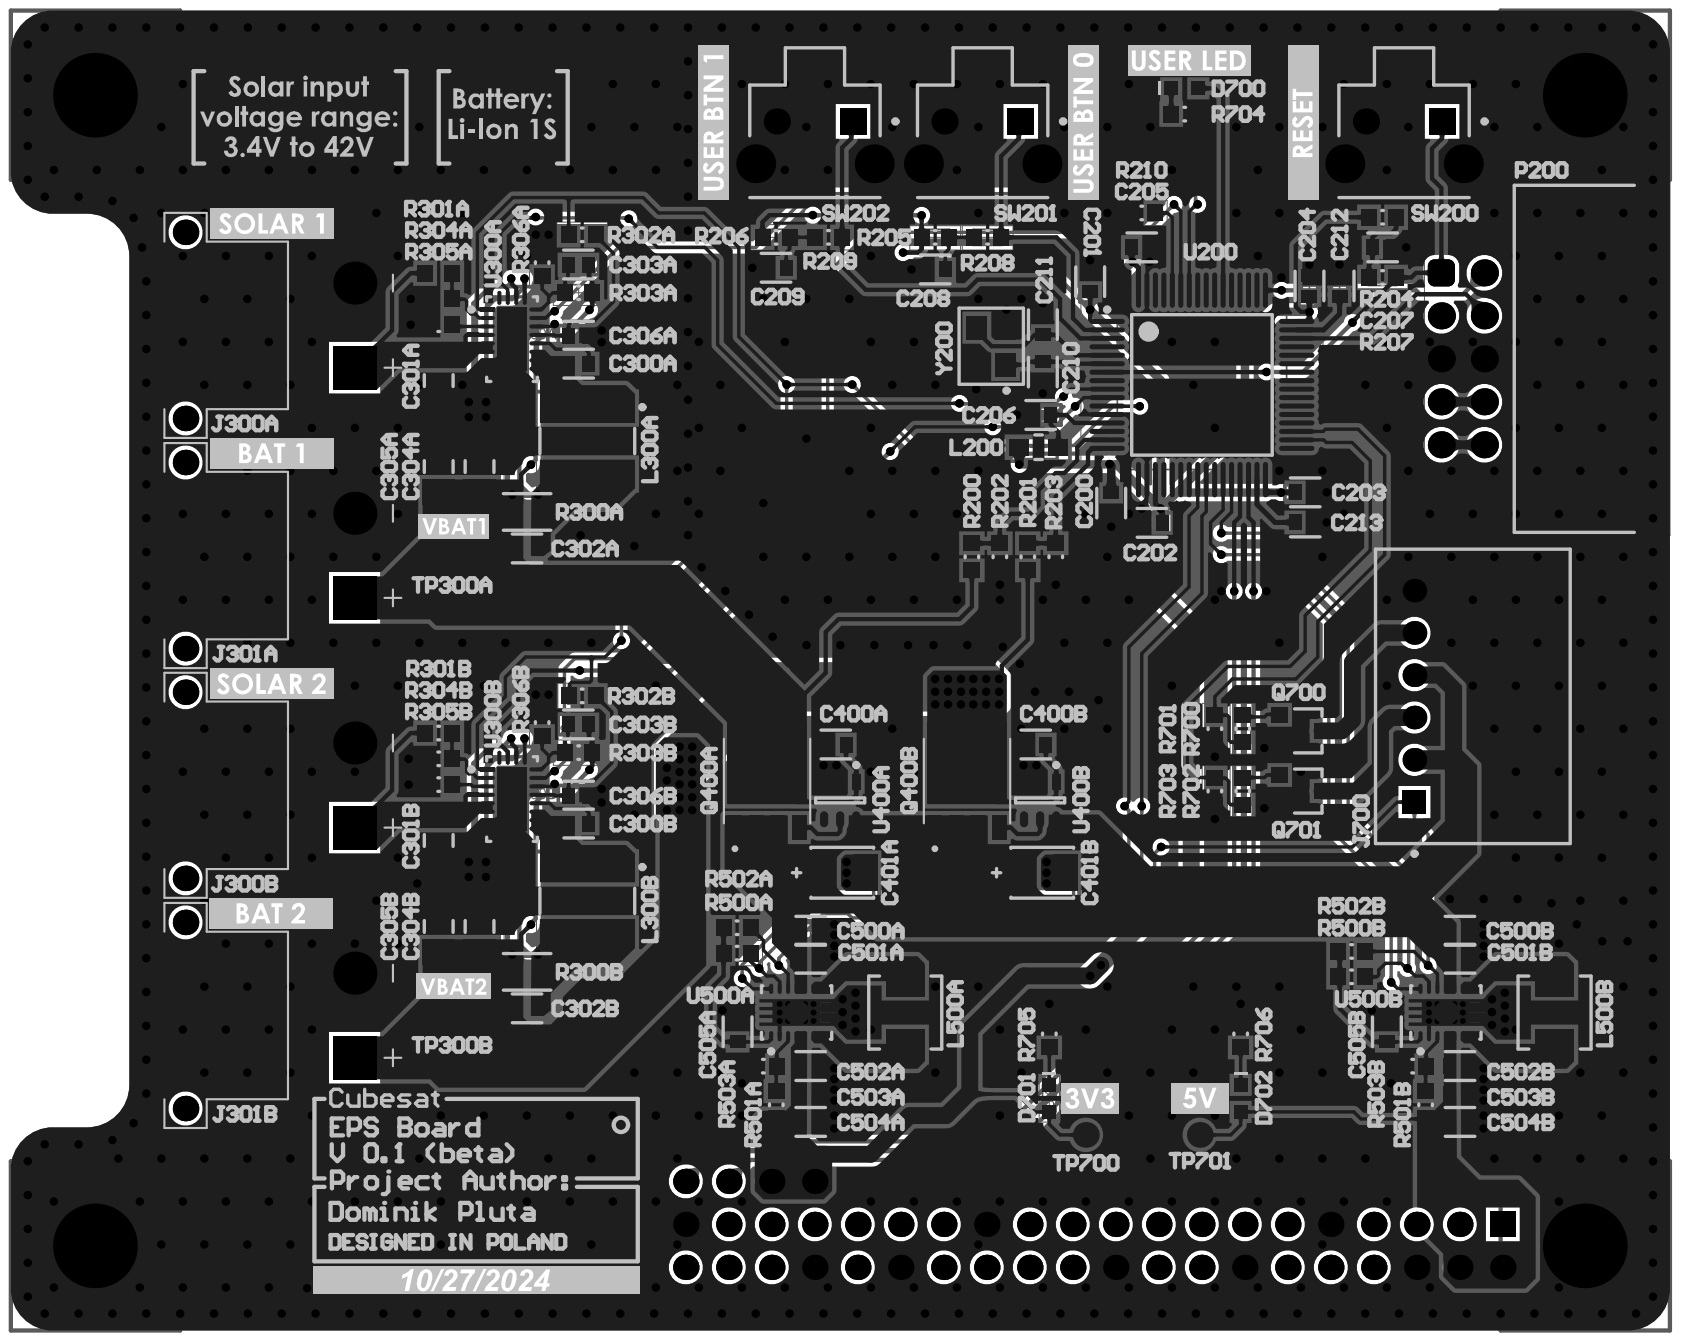
[picture p11: page 11]
