thanhduy1806/EMBEDDED_LAB_TASK_1/(list of files, drawings)

Other design files:
BÀI_1/Board_Connect.SchDoc
BÀI_1/Buck-Boost_1.SchDoc
BÀI_1/Buck-Bost_2.SchDoc
BÀI_1/BÀI_1.PrjPcb
BÀI_1/IDEAL_DIODE_1.SchDoc
BÀI_1/IDEAL_DIODE_2.SchDoc
BÀI_1/LED_CONNECTOR.SchDoc
BÀI_1/MICROCONTROLER.SchDoc
BÀI_1/MPPT_1.SchDoc
BÀI_1/MPPT_2.SchDoc
BÀI_1/PCB2.PcbDoc
BÀI_1/SHEET_SYMBOL.SchDoc
