thanhduy1806/EMBEDDED_LAB_TASK_1/(commit log)

2024-11-03 Complete Schematic
    [BOM.xlsx, Board_Connect.SchDoc, Buck-Boost_1.SchDoc, Buck-Bost_2.SchDoc, BÀI_1.PrjPcb, IDEAL_DIODE_1.SchDoc, IDEAL_DIODE_2.SchDoc, LED_CONNECTOR.SchDoc]
2024-11-04 update lib
    [Board_Connect.SchDoc, Buck-Boost_1.SchDoc, Buck-Bost_2.SchDoc, BÀI_1.PrjPcb, IDEAL_DIODE_1.SchDoc, IDEAL_DIODE_2.SchDoc, LED_CONNECTOR.SchDoc, MICROCONTROLER.SchDoc]
2024-11-04 arrange layout
    [Buck-Boost_1.SchDoc, Buck-Bost_2.SchDoc, BÀI_1.PrjPcb, IDEAL_DIODE_1.SchDoc, IDEAL_DIODE_2.SchDoc, LED_CONNECTOR.SchDoc, MICROCONTROLER.SchDoc, MPPT_1.SchDoc]
2024-11-07 routing PCB
    [Board_Connect.SchDoc, BÀI_1.PrjPcb, LED_CONNECTOR.SchDoc, MICROCONTROLER.SchDoc, MPPT_1.SchDoc, MPPT_2.SchDoc, SHEET_SYMBOL.SchDoc]
2024-11-09 completed PCB 2L, not completed PCB 4L
    [Buck-Boost_1.SchDoc, Buck-Bost_2.SchDoc, BÀI_1.PrjPcb, LED_CONNECTOR.SchDoc, MICROCONTROLER.SchDoc, MPPT_1.SchDoc, MPPT_2.SchDoc, SHEET_SYMBOL.SchDoc]
2024-11-10 completed schematic, pcb 2l, BOM
    [BÀI_1.PrjPcb]
